FlyingLights/FlyingLights/images/IMG_2771.jpg

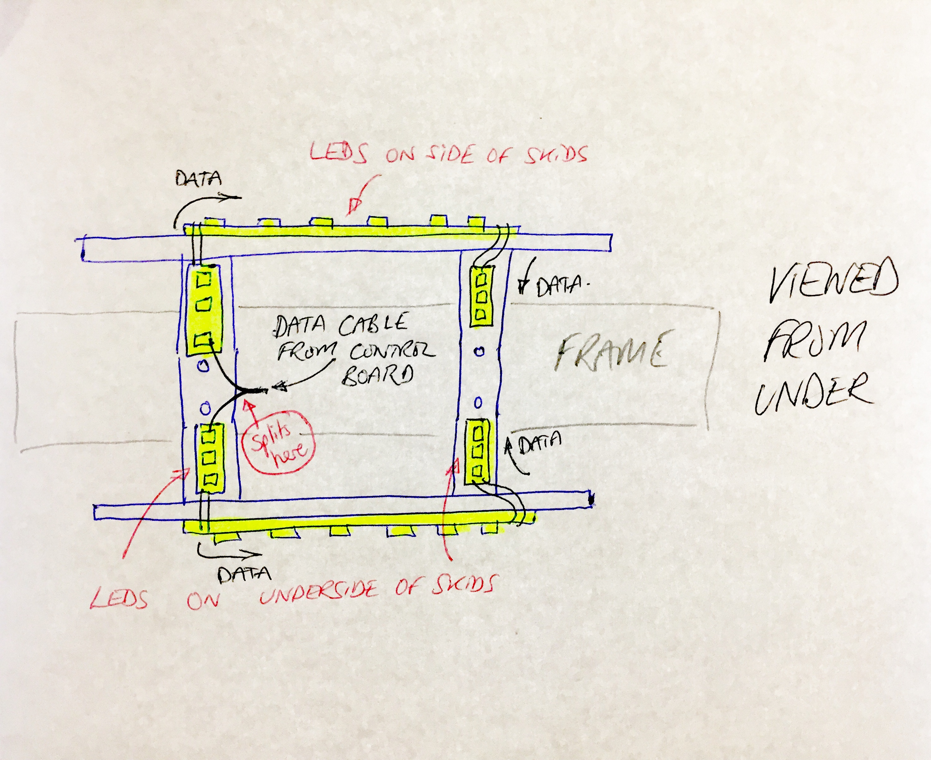
images/IMG_2771.jpg
