FlyingLights/FlyingLights/images/IMG_2776.jpg

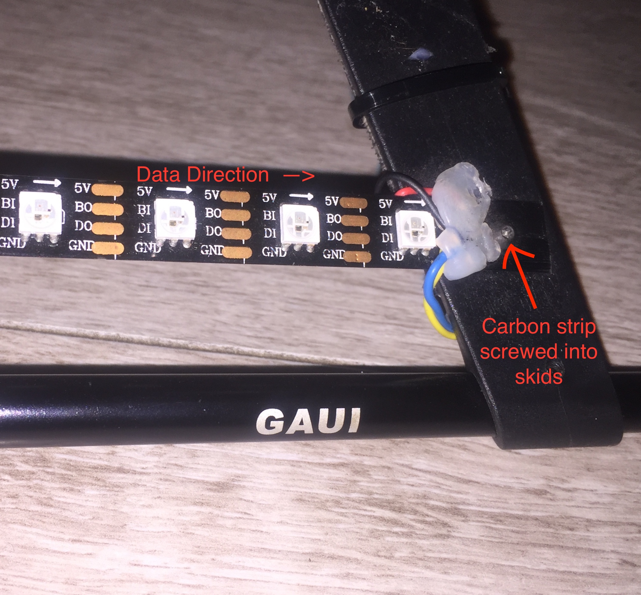
images/IMG_2776.jpg
