FlyingLights/FlyingLights/Ground Control Systems/README.md

# Ground Control Systems

The ground control system triggers the LEDs on the helicopter and music on a radio-controlled MP3 player. There are three different versions to chose from. To get started, we suggest you build the simple one.

<a href="https://github.com/FlyingLights/FlyingLights/wiki/Ground-Control-Systems">See here for more info</a>
