FlyingLights/FlyingLights/Heli System/README.md

### Flyinglights_Receiver.ino
This is the code that runs on a Feather M0 LORA board. It receives radio data from the ground control system and drives the onboard RGB LEDs.
