FlyingLights/FlyingLights/images/Heli Control Board.png

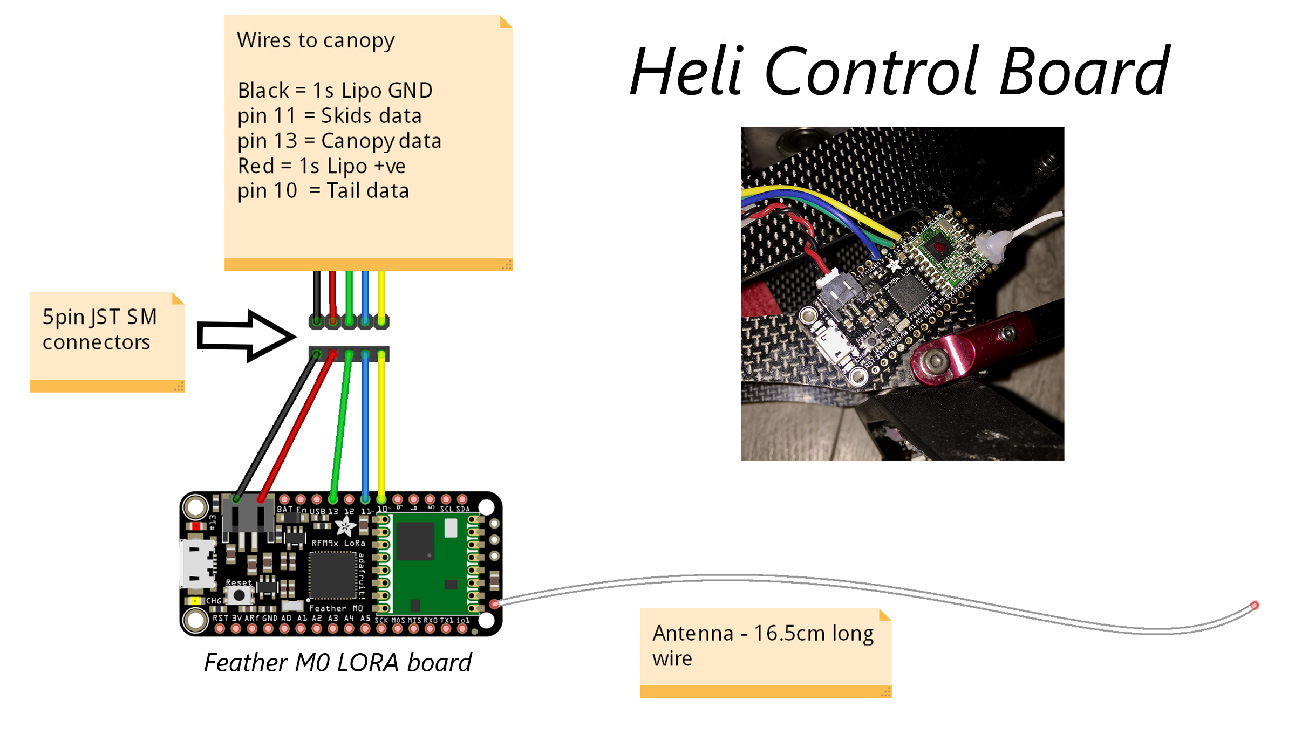
images/Heli Control Board.png
