FlyingLights/FlyingLights/images/IMG_2688.JPG

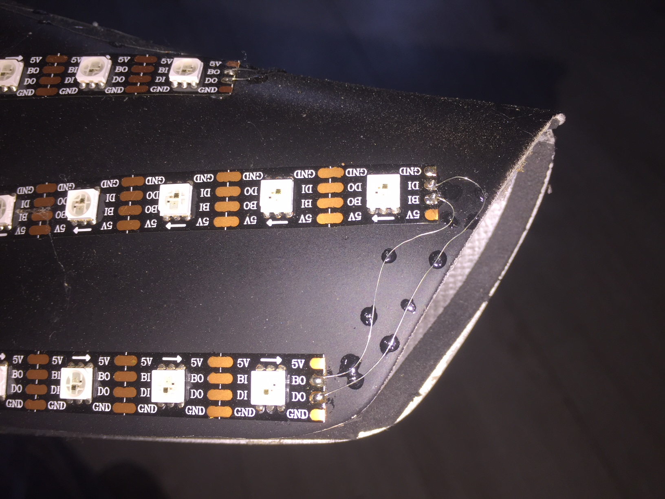
images/IMG_2688.JPG
