FlyingLights/FlyingLights/images/IMG_2690.JPG

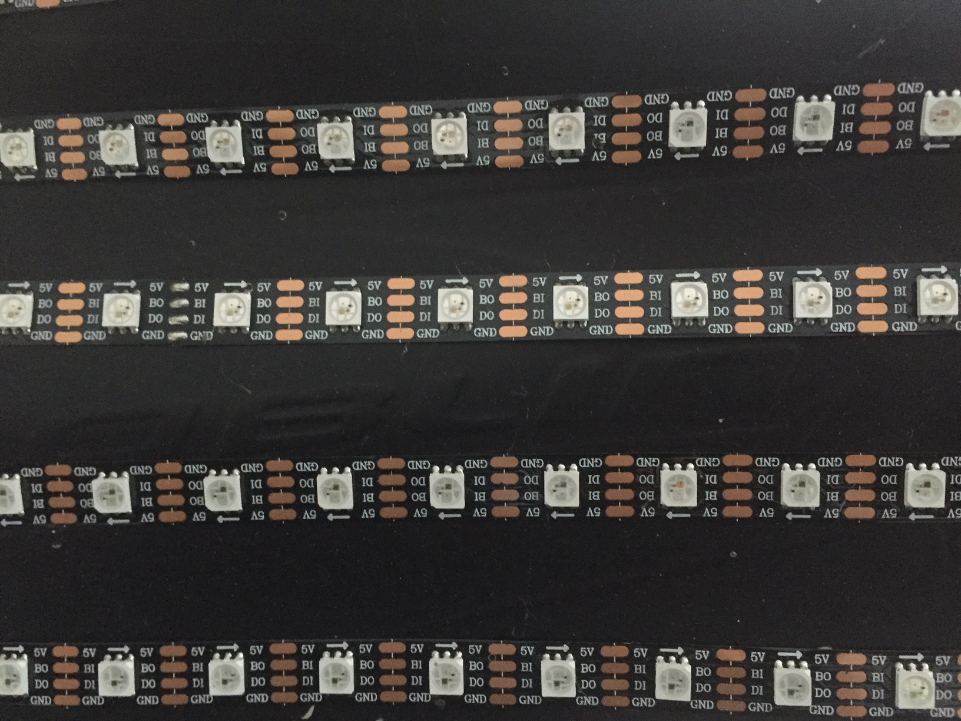
images/IMG_2690.JPG
