FlyingLights/FlyingLights/images/IMG_2767.jpg

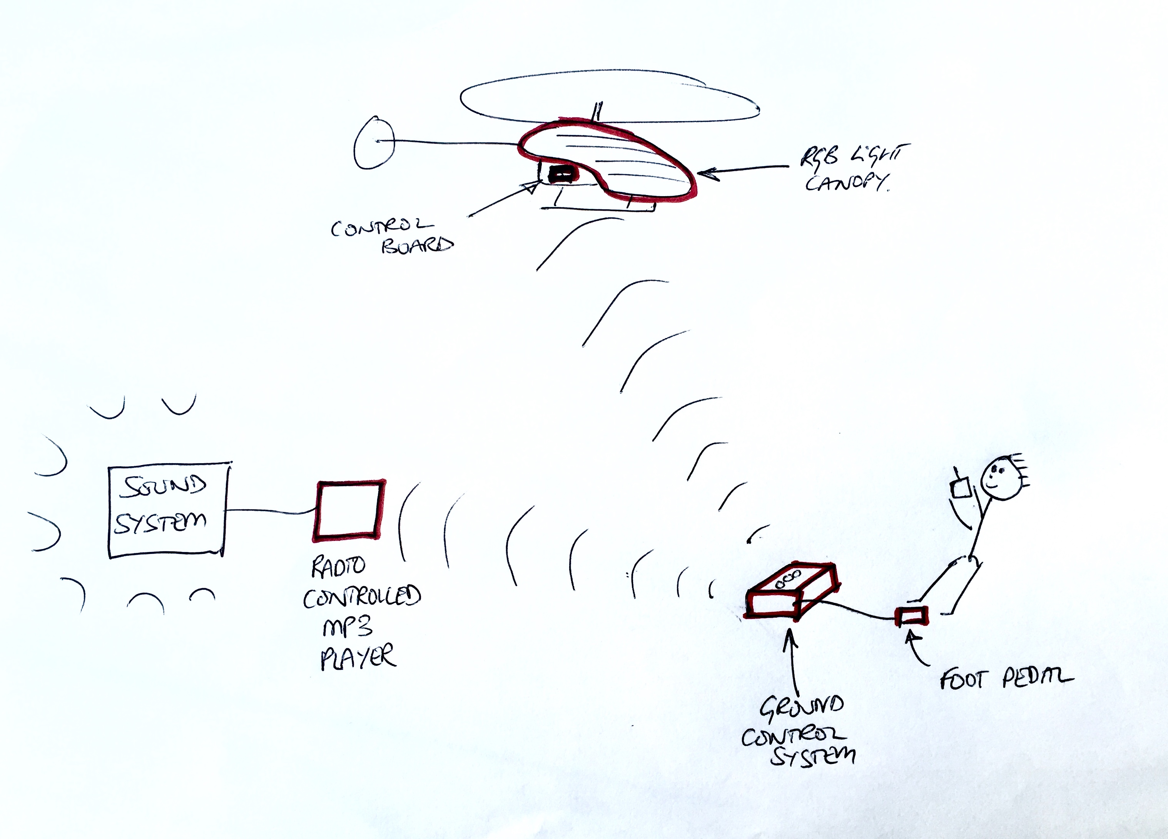
images/IMG_2767.jpg
