FlyingLights/FlyingLights/images/IMG_2773.jpg

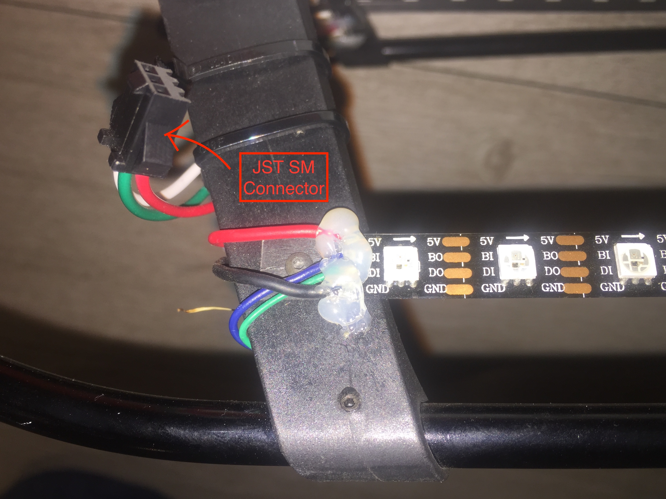
images/IMG_2773.jpg
