FlyingLights/FlyingLights/images/IMG_2774.jpg

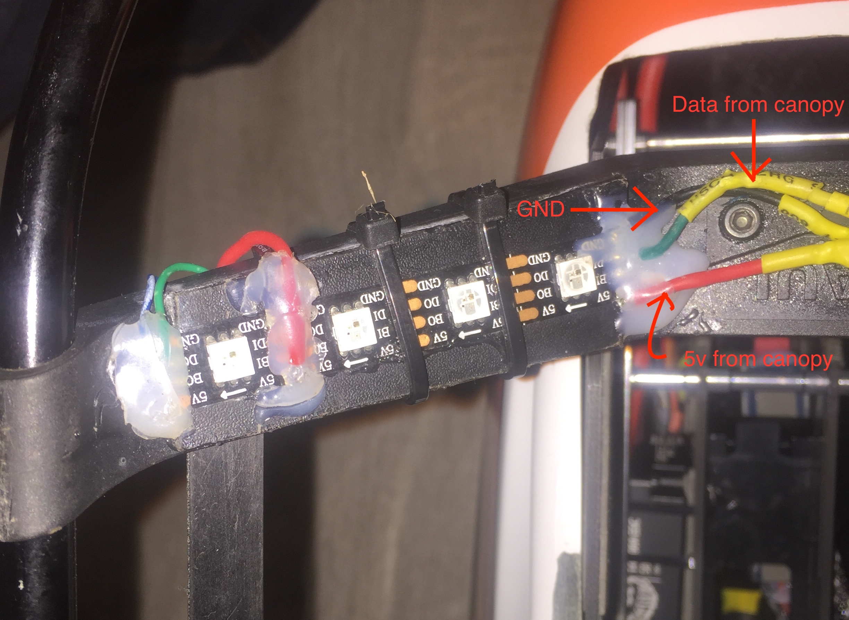
images/IMG_2774.jpg
