FlyingLights/FlyingLights/images/jst_sm.jpg

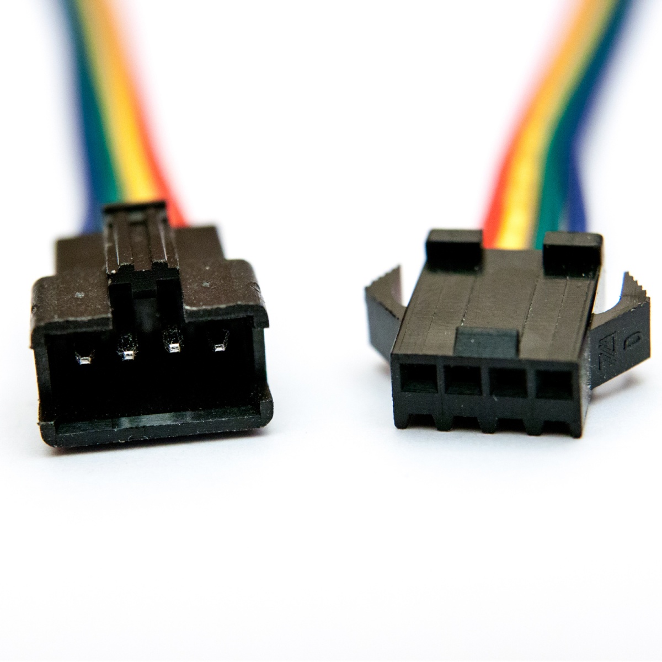
images/jst_sm.jpg
