FlyingLights/FlyingLights/images/softfocuscanopy.jpg

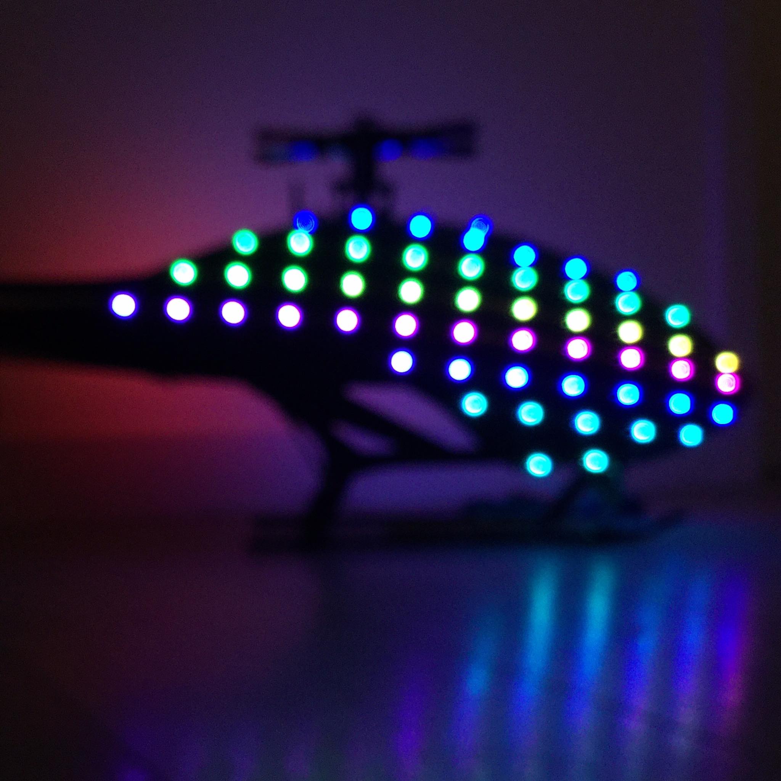
images/softfocuscanopy.jpg
