FlyingLights/FlyingLights/images/sonicvis.png

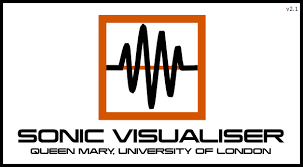
images/sonicvis.png
