FlyingLights/FlyingLights/images/tamiya.jpg

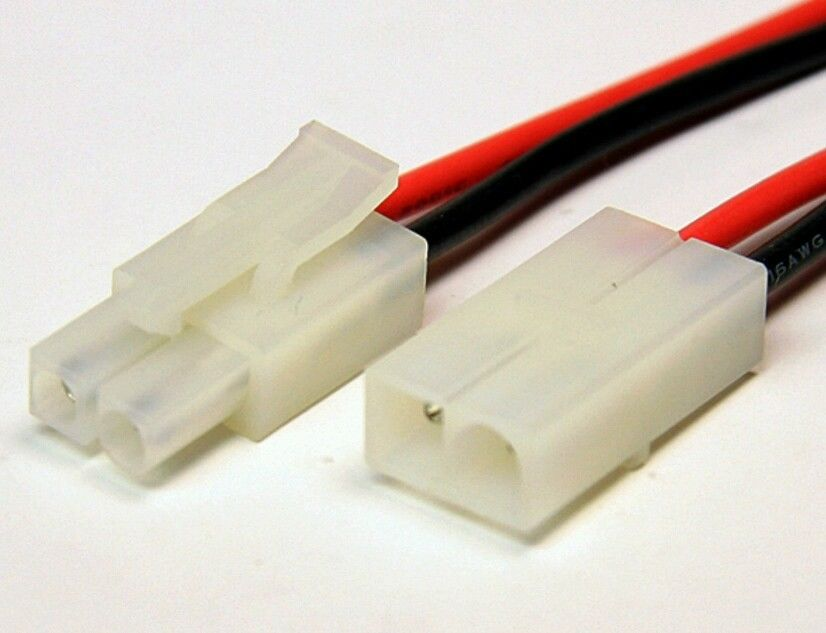
images/tamiya.jpg
