FlyingLights/FlyingLights/images/ultimate control_bb.png

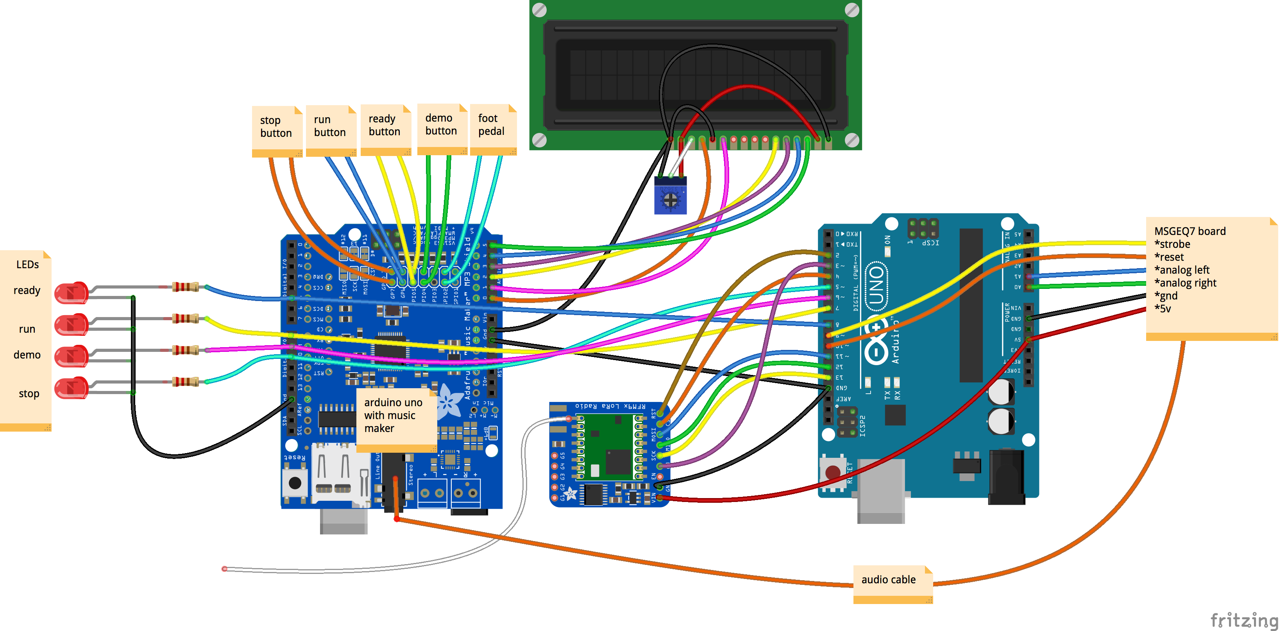
images/ultimate control_bb.png
