FlyingLights/FlyingLights/images/how_to_download.JPG

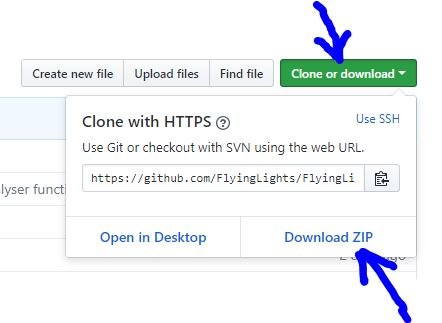
images/how_to_download.JPG
