FlyingLights/FlyingLights/MP3 Players/UNO MP3 Player/MP3_Player/MP3_Player.ino

// This code is designed to run on an Arduino Uno mp3 player
// It has an adafruit music maker board stacked on top of it and is connected by I2C
// to another board which is running I2C_Receiver and is connected to a LORA radio.

// include SPI, MP3, SD and I2C libraries
#include <SPI.h>
#include <Adafruit_VS1053.h>
#include <SD.h>
#include <Wire.h>




// Feather M0 or 32u4
#if defined(__AVR__) || defined(ARDUINO_SAMD_FEATHER_M0)
#define SHIELD_RESET  -1      // VS1053 reset pin (unused!)
  #define SHIELD_CS       6     // VS1053 chip select pin (output)
  #define SHIELD_DCS     10     // VS1053 Data/command select pin (output)
  #define CARDCS          5     // Card chip select pin
  #define DREQ     9     // VS1053 Data request, ideally an Interrupt pin
 
#else 
// These are the pins used for the music maker shield connected to UNO
#define SHIELD_RESET  -1      // VS1053 reset pin (unused!)
#define SHIELD_CS     7      // VS1053 chip select pin (output)
#define SHIELD_DCS    6      // VS1053 Data/command select pin (output)
#define CARDCS 4     // Card chip select pin
#define DREQ 3       // VS1053 Data request, ideally an Interrupt pin
#endif


Adafruit_VS1053_FilePlayer musicPlayer = Adafruit_VS1053_FilePlayer(SHIELD_RESET, SHIELD_CS, SHIELD_DCS, DREQ, CARDCS);

uint8_t mode; //the mode received from I2C_Receiver
uint8_t oldmode; //to pick up if the mode has changed

void setup() {

  Wire.begin();        // join i2c bus (address optional for master)
  //   Wire.setClock(100000);
  Serial.begin(115200); // for debugging

   while (!Serial) { delay(1); }

  Serial.println("\n\nAdafruit VS1053 Feather Test");
  
  if (! musicPlayer.begin()) { // initialise the music player
     Serial.println(F("Couldn't find VS1053, do you have the right pins defined?"));
     while (1);
  }
  Serial.println(F("VS1053 found"));

musicPlayer.sineTest(0x45, 500);    // Make a tone to indicate VS1053 is working

  if (!SD.begin(CARDCS)) {
    Serial.println(F("SD failed, or not present"));
    while (1);  // don't do anything more
  }
  Serial.println("SD OK!");

  // Set volume for left, right channels. lower numbers == louder volume!
  musicPlayer.setVolume(1, 1); //this is loud!

  // This option uses a pin interrupt. No timers required! But DREQ
  // must be on an interrupt pin. For Uno/Duemilanove/Diecimilla
  // that's Digital #2 or #3

  
  if (! musicPlayer.useInterrupt(VS1053_FILEPLAYER_PIN_INT))
    Serial.println(F("DREQ pin is not an interrupt pin"));
}

void loop() {
  Wire.requestFrom(2, 1);    // request 1 bytes from the I2C_Receiver
  
  while (Wire.available()) { // slave may send less than requested
    mode = Wire.read(); // receive the mode
    Serial.println(mode);   // print the character for debugging
  }

  if (mode != oldmode) { //if the mode has changed

    if (mode == 1) { //run mode
      musicPlayer.stopPlaying(); //stop playing first in case it was in demo mode
      musicPlayer.startPlayingFile("music.mp3"); // play the run music
    }

    else if (mode == 4) {
      musicPlayer.stopPlaying();  //stop playing first
      musicPlayer.startPlayingFile("demo.mp3");  // play the demo music
    }

    else {
      musicPlayer.stopPlaying(); //stop playing, it is not in run or demo mode
    }
  }

  oldmode = mode;
}
