FlyingLights/FlyingLights/(commit log)

2018-08-11 add excel files for making arrays
    [leftcanopy_array_maker.xlsx, rightcanopy_array_maker.xlsx]
2018-08-11 finish right array maker
    [rightcanopy_array_maker.xlsx]
2018-08-13 spelling mistake in comments!
    [Music_Buttons_Display.ino]
2018-08-15 Change from 32bit to 24 bit millis
2018-08-24 Introduce use of runthrough boolean
    Runthrough introduced to cut down on the number of functions. This way most of the same functions can be used in Run & Demo/Ready
2018-09-02 Add sprites.xlsx
    This file defines the letters/numbers and other shapes which are on a 5x5 grid
    [sprites.xlsx]
2018-09-07 V1 of I2C_Receiver
    This code is for boards connecdted to a Lora radio and acting as an I2C slave to another board
2018-09-07 V1 of mp3 player code
    Runs on arduino attached to Adafruit Music Maker. This connects to the sound deskk.
2018-09-09 Simple transmitter
    Code for simple transmitter. Just a Feather M0 LORA board with a foot pedal attached between GND and A2.
2018-09-09 Increase transmitter power and change to UNIQUE_ADDRESSS
2018-09-11 Sketch of how to wire skid leds
